GfRdKuni/NPU/README.md

# NPU
This is an NPU design for Introduction of Intelligent Computing Chips Course
