GfRdKuni/NPU/tex_src/Addr_Map.jpg

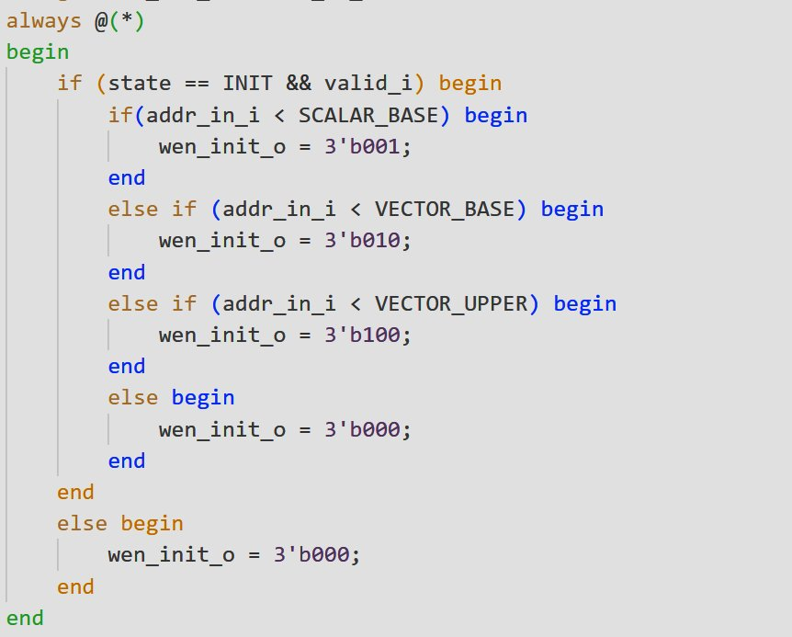
tex_src/Addr_Map.jpg
