GfRdKuni/NPU/Testbench/Testbench/Readme.md

You can generate your own final stimulus file by running `integral` in `../Matlab_TB_Generation` folder. 

But do remember to change the `NUM_CYCLES` Parameter which is equal to the total instructions number in the `INIT_tb`file!
