GfRdKuni/NPU/Testbench/Intermediate_file/opt/result_opt.txt

2004
1A78
18BD
159F
1D2F
2197
28A5
1AAB
1A9A
1533
1837
1618
1B21
20B8
27F9
1A40
2144
18E1
21F4
183B
23AC
2027
2464
21A8
21DB
14F9
22A2
2076
1EAF
2528
2487
2859
21B5
1856
1D79
1A87
2175
23AD
2516
2332
24E4
1C86
2A68
2340
2769
278E
28B6
2E47
24BD
1915
242E
1C40
269A
2625
29E5
28FD
130D
13C4
2158
1827
25EA
1DAD
237F
1BAF
