GfRdKuni/NPU/Testbench/Intermediate_file/original/result.txt

2EE9
16A4
1C36
2011
29F5
1926
2766
1BF1
2DA8
1FF9
222E
2E42
2F13
1D8D
2A8E
2D52
2924
1AE8
1BB2
1A2D
1E4D
1DFB
1C29
1B08
3CA6
2621
283D
2F00
37F6
2430
37E7
2994
1D24
1068
1100
1F94
20EC
1114
1FDB
1F11
317A
284E
274C
28A3
2A7F
264E
2A63
24DD
3B3E
24DB
268C
2C7A
3061
24BD
30B4
2934
2090
19D5
1C4B
214A
243F
1490
201F
1E4F
